Vibhors-Tech-Hub/Ki-pad/production/BOM.csv

Designator | Footprint | Quantity | Description | MPN
C1, C2, C3, C4, C5, C6, C7, C8, C9, C10, C11, C12, C13 | 0805 | 13 | 100n
D1, D2, D3, D4, D5, D6, D7, D8, D9, D10, D11, D12 | SOD-123F | 12 | IN4148W | IN4148W
D13, D14, D15, D16, D17, D18, D19, D20, D21, D22, D23, D24 | SK6812MINI-E | 12 | SK6812MINI-E | SK6812MINI-E
R1, R2, R3, R4 | 0805 | 4 | 10k
S1, S2 | PEC11R-4220F-S0024 | 2 | PEC11R-4220F-S0024 | PEC11R-4220F-S0024
SW1, SW2, SW3, SW4, SW5, SW6, SW7, SW8, SW9, SW10, SW11, SW12 | MX2A-H1NA | 12 | MX2A-H1NA | MX2A-H1NA
U1 | SOT-23-5 | 1 | 74AHCT1G125 | 74AHCT1G125
U2 | RP2040-ZERO | 1 | RP2040-ZERO | Waveshare RP2040 Zero
