Vibhors-Tech-Hub/Ki-pad/3D/Macropad.step

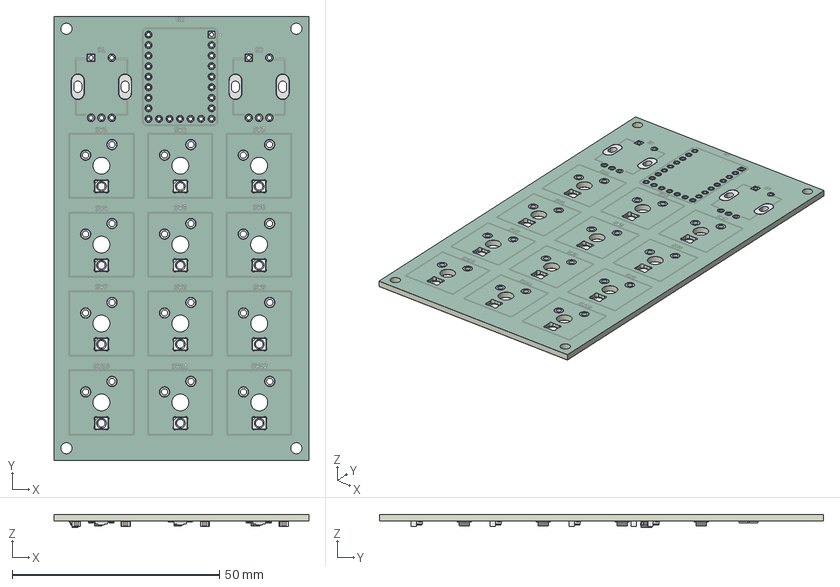
[picture p1: CAD file, 2026-10-31]
3D/Macropad.step
61.6 x 107.2 x 3.22 mm
R_0805_2012Metric x 4
C_0805_2012Metric x 13
D_SOD_123F x 12
Pin1 x 12
Pin2 x 12
Pin3 x 12
Pin4 x 12
SOT-23-5
Macropad_copper
Macropad_pad
Macropad_via
Macropad_silkscreen x 2
Macropad_soldermask x 2
Macropad_PCB
