Vibhors-Tech-Hub/Ki-pad/hardware/Macropad.kicad_pcb

## KiCad design hardware/Macropad.kicad_pcb (2026-10-31)

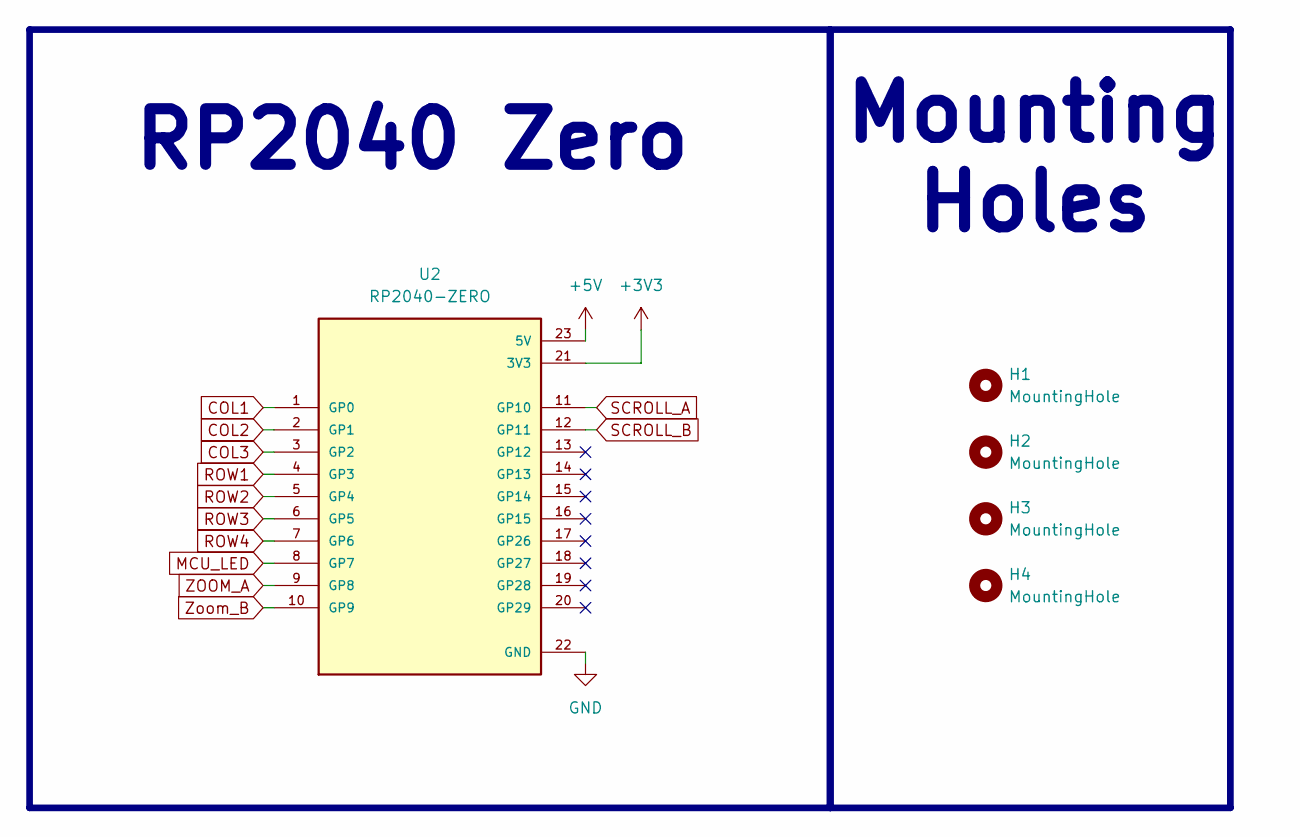
[picture p2: schematic mcu.kicad_sch]

Parts:
H1, H2, H3, H4: MountingHole; MountingHole_2.7mm_M2.5
U2: RP2040-ZERO; PARTREV NA

Connections:
+3V3: U2.21 (3V3); also elsewhere on the board
+5V: U2.23 (5V); also elsewhere on the board
COL1: U2.1 (GP0); also elsewhere on the board
COL2: U2.2 (GP1); also elsewhere on the board
COL3: U2.3 (GP2); also elsewhere on the board
GND: U2.22 (GND); also elsewhere on the board
MCU_LED: U2.8 (GP7); also elsewhere on the board
ROW1: U2.4 (GP3); also elsewhere on the board
ROW2: U2.5 (GP4); also elsewhere on the board
ROW3: U2.6 (GP5); also elsewhere on the board
ROW4: U2.7 (GP6); also elsewhere on the board
SCROLL_A: U2.11 (GP10); also elsewhere on the board
SCROLL_B: U2.12 (GP11); also elsewhere on the board
ZOOM_A: U2.9 (GP8); also elsewhere on the board
Zoom_B: U2.10 (GP9); also elsewhere on the board

Notes on the sheet:
Mounting Holes
RP2040 Zero

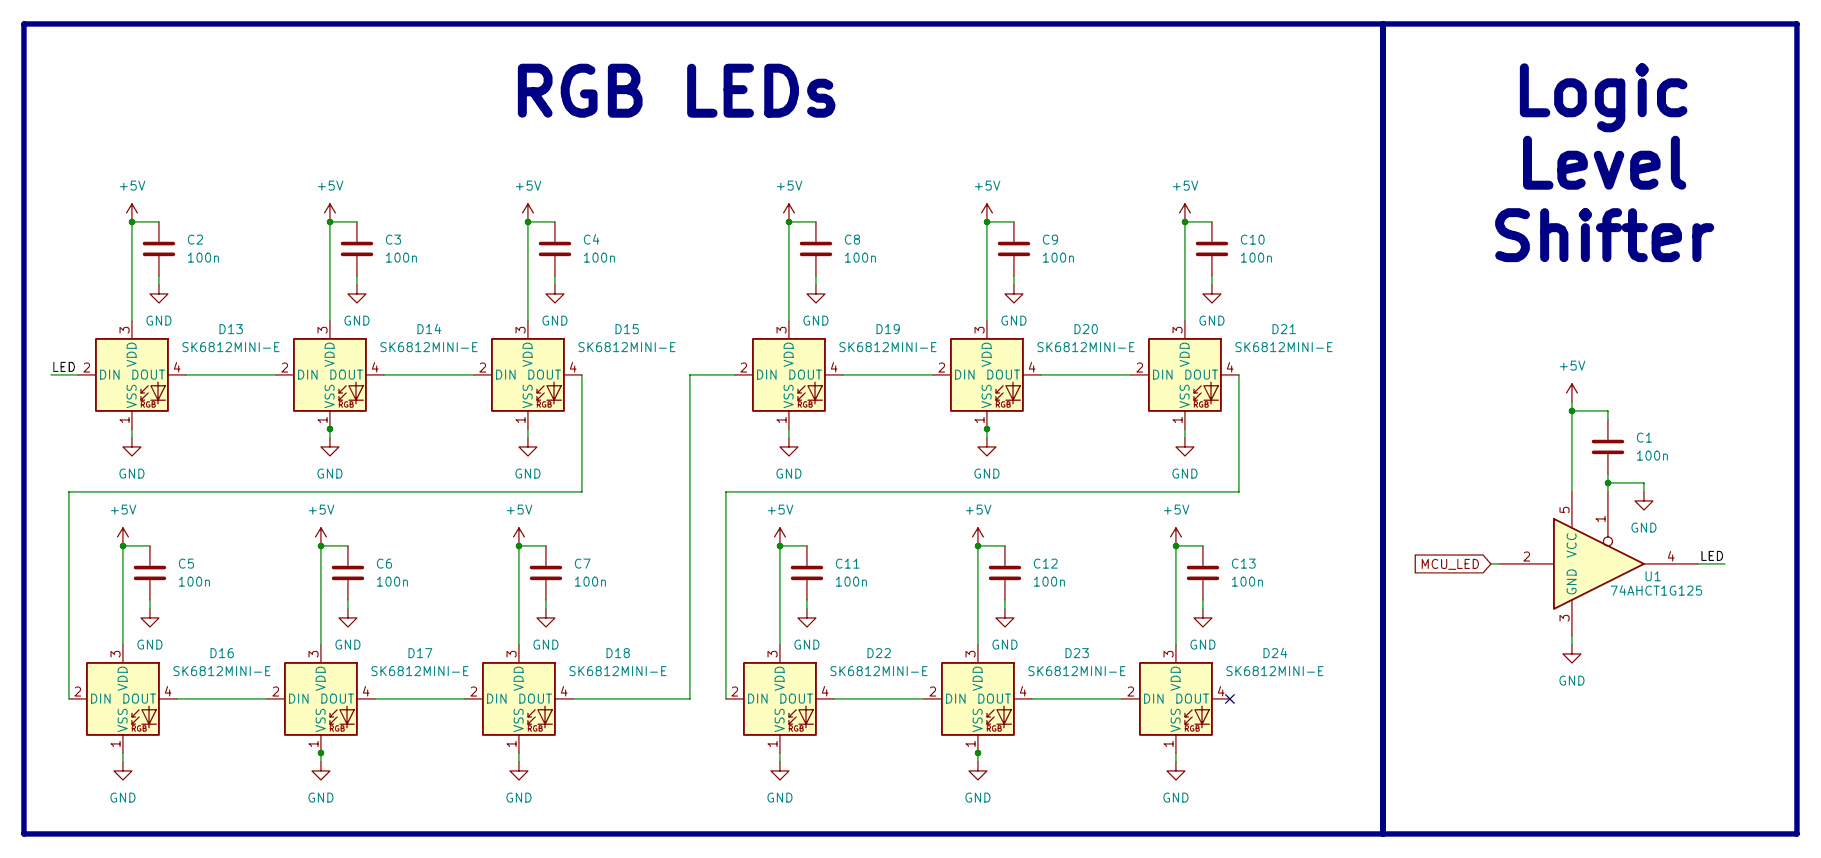
[picture p3: schematic led.kicad_sch]

Parts:
C1, C2, C3, C4, C5, C6, C7, C8, C9, C10, C11, C12, C13: 100n; C_0805_2012Metric_Pad1.18x1.45mm_HandSolder
D13, D14, D15, D16, D17, D18, D19, D20, D21, D22, D23, D24: SK6812MINI-E; LED_SK6812MINI-E_3.2x2.8mm_P1.5mm_ReverseMount
U1: 74AHCT1G125; SOT-23-5_HandSoldering

Connections:
+5V: C1.1, C2.1, C3.1, C4.1, C5.1, C6.1, C7.1, C8.1, C9.1, C10.1, C11.1, C12.1, C13.1, D13.3 (VDD), D14.3 (VDD), D15.3 (VDD), D16.3 (VDD), D17.3 (VDD), D18.3 (VDD), D19.3 (VDD), D20.3 (VDD), D21.3 (VDD), D22.3 (VDD), D23.3 (VDD), D24.3 (VDD), U1.5 (VCC); also elsewhere on the board
/LED/LED: D13.2 (DIN), U1.4
GND: C1.2, C2.2, C3.2, C4.2, C5.2, C6.2, C7.2, C8.2, C9.2, C10.2, C11.2, C12.2, C13.2, D13.1 (VSS), D14.1 (VSS), D15.1 (VSS), D16.1 (VSS), D17.1 (VSS), D18.1 (VSS), D19.1 (VSS), D20.1 (VSS), D21.1 (VSS), D22.1 (VSS), D23.1 (VSS), D24.1 (VSS), U1.1, U1.3 (GND); also elsewhere on the board
MCU_LED: U1.2; also elsewhere on the board
unnamed: D13.4 (DOUT), D14.2 (DIN)
unnamed: D14.4 (DOUT), D15.2 (DIN)
unnamed: D15.4 (DOUT), D16.2 (DIN)
unnamed: D16.4 (DOUT), D17.2 (DIN)
unnamed: D17.4 (DOUT), D18.2 (DIN)
unnamed: D18.4 (DOUT), D19.2 (DIN)
unnamed: D19.4 (DOUT), D20.2 (DIN)
unnamed: D20.4 (DOUT), D21.2 (DIN)
unnamed: D21.4 (DOUT), D22.2 (DIN)
unnamed: D22.4 (DOUT), D23.2 (DIN)
unnamed: D23.4 (DOUT), D24.2 (DIN)

Notes on the sheet:
RGB LEDs
Logic Level Shifter

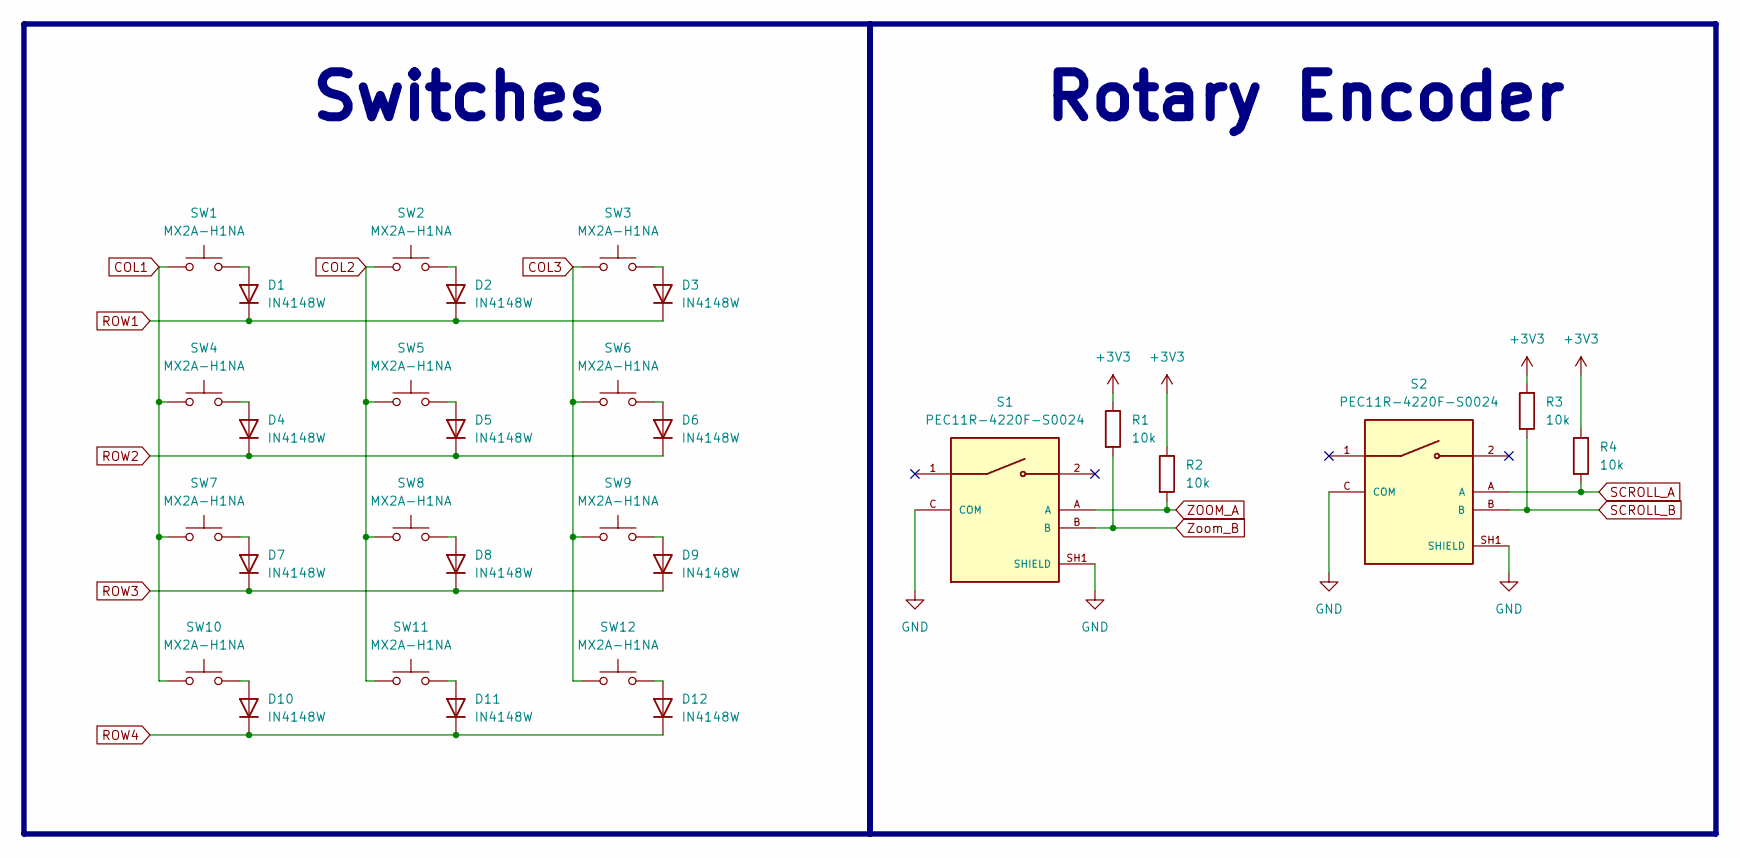
[picture p4: schematic interface.kicad_sch]

Parts:
D1, D2, D3, D4, D5, D6, D7, D8, D9, D10, D11, D12: IN4148W; D_SOD-123F
R1, R2, R3, R4: 10k; R_0805_2012Metric_Pad1.20x1.40mm_HandSolder
S1, S2: PEC11R-4220F-S0024; PARTREV 11/23
SW1, SW2, SW3, SW4, SW5, SW6, SW7, SW8, SW9, SW10, SW11, SW12: MX2A-H1NA; MX1A-11NN

Connections:
+3V3: R1.1, R2.1, R3.1, R4.1; also elsewhere on the board
COL1: SW1.1, SW4.1, SW7.1, SW10.1; also elsewhere on the board
COL2: SW2.1, SW5.1, SW8.1, SW11.1; also elsewhere on the board
COL3: SW3.1, SW6.1, SW9.1, SW12.1; also elsewhere on the board
GND: S1.C (COM), S1.SH1 (SHIELD), S1.SH2 (SHIELD), S2.C (COM), S2.SH1 (SHIELD), S2.SH2 (SHIELD); also elsewhere on the board
unnamed: D1.2 (A), SW1.2
unnamed: D2.2 (A), SW2.2
unnamed: D3.2 (A), SW3.2
unnamed: D4.2 (A), SW4.2
unnamed: D5.2 (A), SW5.2
unnamed: D6.2 (A), SW6.2
unnamed: D7.2 (A), SW7.2
unnamed: D8.2 (A), SW8.2
unnamed: D9.2 (A), SW9.2
unnamed: D10.2 (A), SW10.2
unnamed: D11.2 (A), SW11.2
unnamed: D12.2 (A), SW12.2
ROW1: D1.1 (K), D2.1 (K), D3.1 (K); also elsewhere on the board
ROW2: D4.1 (K), D5.1 (K), D6.1 (K); also elsewhere on the board
ROW3: D7.1 (K), D8.1 (K), D9.1 (K); also elsewhere on the board
ROW4: D10.1 (K), D11.1 (K), D12.1 (K); also elsewhere on the board
SCROLL_A: R4.2, S2.A; also elsewhere on the board
SCROLL_B: R3.2, S2.B; also elsewhere on the board
ZOOM_A: R2.2, S1.A; also elsewhere on the board
Zoom_B: R1.2, S1.B; also elsewhere on the board

Notes on the sheet:
Rotary Encoder
Switches

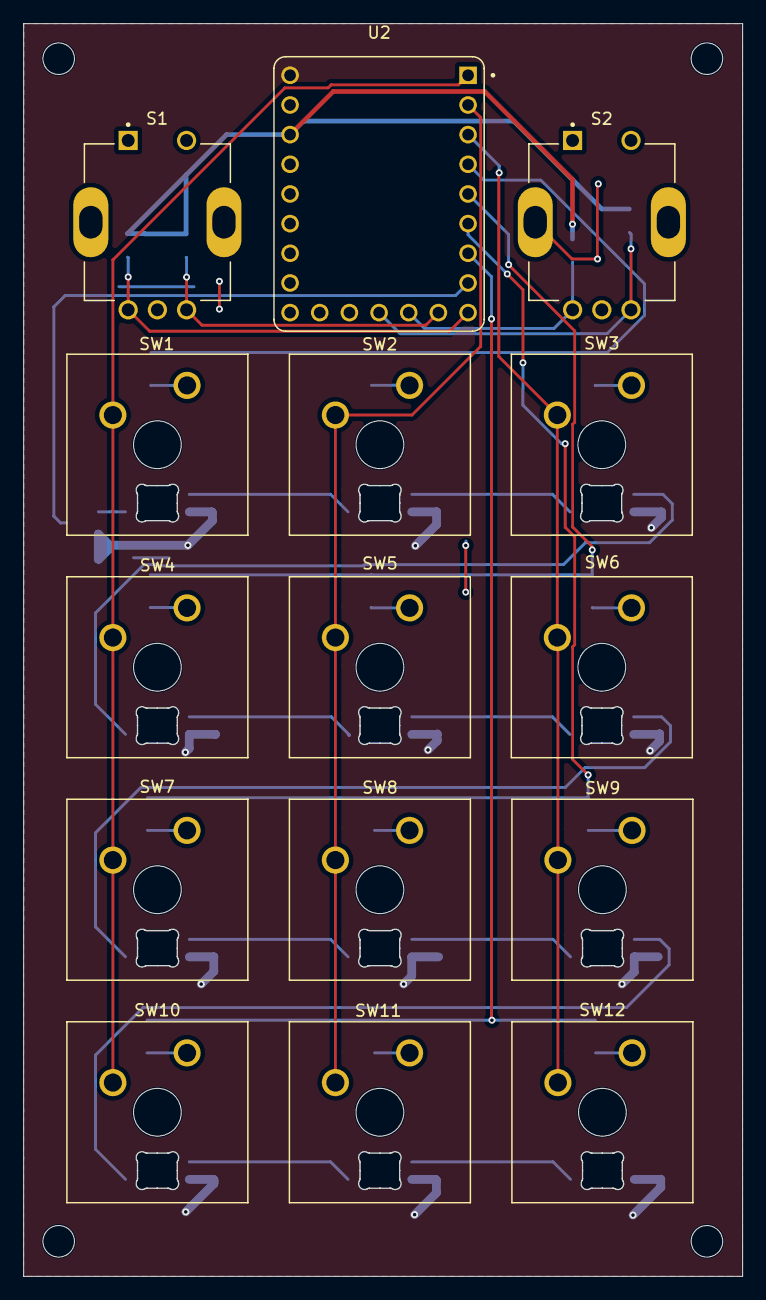
[picture p5: board Macropad.kicad_pcb from above]

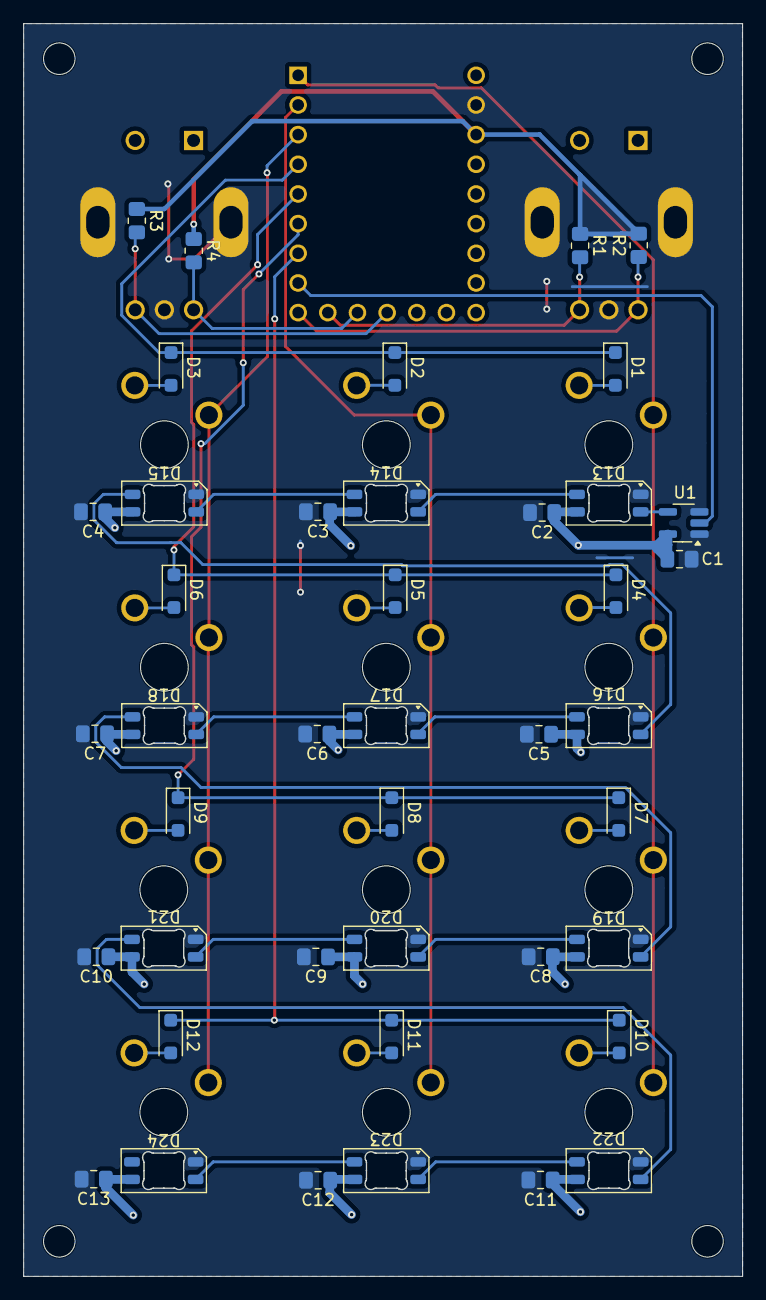
[picture p6: board Macropad.kicad_pcb from below]

Board: 2 copper layers, 61.6 x 107.2 mm, 61 parts (42 on the bottom side), 39 nets.
