Vibhors-Tech-Hub/Ki-pad/(commit log)

2026-10-30 Design Schematic
    [Macropad.kicad_pcb, Macropad.kicad_sch, interface.kicad_sch, led.kicad_sch, mcu.kicad_sch]
2026-10-30 Assign footrpints
    [interface.kicad_sch, led.kicad_sch, mcu.kicad_sch]
2026-10-31 Place components
    [Macropad.kicad_pcb, interface.kicad_sch, led.kicad_sch, mcu.kicad_sch]
2026-10-31 Route and verify PCB
    [Macropad.kicad_pcb, interface.kicad_sch, led.kicad_sch]
2026-10-31 Generate production files and 3D model
    [BOM.csv, Macropad.kicad_pcb, Macropad.step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]
2026-10-31 Add mounting holes
    [Macropad.kicad_pcb, Macropad.step, mcu.kicad_sch]
2026-10-31 Fix copper planes on top and bottom layer
    [Macropad.kicad_pcb]
2026-11-05 Fix typos in README enclosure description
